snevindsouza/MAX10_Eval_Board_Design/bom/ALTERA_10M08_EVAL_20140911_REV_A_BOM_Altera.xls

MAX R 10 10M08 Eval Kit Board Revised: Thursday, September 11, 2014
150-0991402-A1 Revision: A
Item | Qty | Reference | VALUE | ASSY | DESCRIPTION | MFG | MFG P/N
1 | 1 | C1 | 4.7uF |  | CAP CER 4.7UF 6.3V 10% X5R 0603 | Taiyo Yuden | JMK107BJ475KA-T
2 | 28 | C2,C4,C5,C6,C7,C8,C9,C10,C13,C14,C15,C16,C17,C27,C29,C31,C33,C35,C36,C38,C40,C42,C46,C47,C48,C49,C51,C52 | 0.1uF |  | CAP CER 0.1UF 16V 10% X7R 0402 | Taiyo Yuden | EMK105B7104KV-F
3 | 1 | C3 | 47uF/16V |  | CAP ALUM 47UF 16V 20% SMD | Panasonic | EEE-1CA470WR
4 | 14 | C11,C12,C18,C28,C30,C32,C34,C37,C39,C41,C43,C44,C45,C61 | 1uF |  | CAP CER 1UF 6.3V 10% X5R 0402 | Taiyo Yuden | JMK105BJ105KV-F
5 | 16 | C19,C20,C21,C22,C23,C24,C25,C26,C53,C54,C55,C56,C57,C58,C59,C60 | 1nF |  | CAP CER 1000PF 50V 10% X7R 0402 | Yageo | CC0402KRX7R9BB102
6 | 1 | C50 | 10uF |  | CAP CER 10UF 10V 20% X5R 0603 | Taiyo Yuden | LMK107BJ106MALTD
7 | 5 | D1,D2,D3,D4,D5 | Red |  | LED SUPER RED CLEAR 0603 SMD | LITE-On INC | LTST-C190KRKT
8 | 1 | D6 | Green |  | LED SUPER GREEN CLEAR 0603 SMD | LITE-On INC | LTST-C190KGKT
9 | 2 | JU1,JU2 | 63429-202LF |  | CONN SHUNT SINGLE .100 GOLD | FCI | 63429-202LF
10 | 1 | J1 | SKT_MINIUSB_B_RA |  | CONN MINI USB RCPT RA TYPE B SMD | Multisource | 5075BMR-05-SM-CR
11 | 3 | J2,J4,J5 | PPTC081LFBN-RC |  | CONN HEADER FEMALE 8POS .1" TIN | Sullins Connector Solutions | PPTC081LFBN-RC
12 | 1 | J3 | PPTC081LFBN-RC |  | CONN HEADER FEMALE 8POS .1" TIN | Sullins Connector Solutions | PPTC081LFBN-RC
13 | 2 | J6,J7 | HEADER 3 |  | CONN HEADER VERT SGL 3POS GOLD | 3M | 961103-6404-AR
14 | 2 | J8,J9 | Header2x20 | DNI | CONN HEADER FMAL 40PS.1" DL GOLD | Sullins Connector Solutions | PPPC202LFBN-RC
15 | 1 | J10 | 70246-1004 |  | 2.54MM CGRID HDR 10CKT GOLD | Molex Inc | 702461004
16 | 1 | J11 | 87227-3 | DNI | CONN HEADER VERT .100 6POS 15AU | TE Connectivity | 87227-3
17 | 2 | L1,L2 | 600ohm 500mA |  | Ferrite Bead 600ohm@100MHz 500mA 0603 | Murata | BLM18AG601SN1D
18 | 1 | L3 | Ferrite Bead |  | FERRITE CHIP BEAD 47 OHM 0402 | TDK Corporation | MMZ1005F470C
19 | 2 | R1,R4 | 0.1 |  | RES 0.1 OHM 1/2W 1% 0805 WIDE | Rohm Semiconductor | LTR10EVHFLR100
20 | 18 | R2,R15,R51,R52,R53,R57,R58,R59,R60,R61,R62,R64,R65,R66,R67,R68,R69,R72 | 1K |  | RES 1.0K OHM 1/16W 5% 0402 SMD | Yageo | RC0402JR-071KL
21 | 1 | R3 | 100 | DNI | RES 100 OHM 1/8W 1% 0805 SMD | Yageo | RC0805FR-07100RL
22 | 13 | R6,R25,R26,R27,R38,R40,R47,R63,R70,R73,R75,R76,R77 | 0 |  | RES 0.0 OHM 1/16W JUMP 0402 SMD | Yageo | RC0402JR-070RL
23 | 15 | R7,R8,R9,R10,R17,R18,R19,R20,R78,R79,R80,R81,R82,R83,R85 | 316 |  | RES 316 OHM 1/10W 1% 0402 SMD | Panasonic Electronic Components | ERJ-2RKF3160X
24 | 1 | R16 | 10K | DNI | TRIMMER 10K OHM 0.1W SMD | Murata | PVZ3A103C01R00
25 | 19 | R29,R30,R31,R32,R33,R34,R35,R36,R37,R39,R41,R42,R43,R44,R45,R46,R48,R49,R50 | 100 | DNI | RES 100 OHM 1/10W 1% 0603 SMD | Yageo | RC0603FR-07100RL
26 | 3 | R54,R55,R56 | 10K |  | RES 10K OHM 1/16W 5% 0402 SMD | Yageo | RC0402JR-0710KL
27 | 1 | R74 | 0 | DNI | RES 0.0 OHM 1/16W JUMP 0402 SMD | Yageo | RC0402JR-070RL
28 | 1 | R84 | 316 | DNI | RES 316 OHM 1/10W 1% 0402 SMD | Panasonic Electronic Components | ERJ-2RKF3160X
29 | 8 | R86,R87,R88,R89,R90,R91,R92,R93 | 100 |  | RES 100 OHM 1/16W 1% 0402 SMD | Yageo | RC0402FR-07100RL
30 | 1 | R94 | 10K | DNI | TRIMMER 10K OHM 0.5W PC PIN | Bourns | 3362P-1-103TLF
31 | 2 | SW1,SW2 | PTS645SM43SMTR92 LFS |  | SWITCH TACTILE SPST-NO 0.05A 12V | C&K Components | PTS645SM43SMTR92 LFS
32 | 1 | SW3 | 219-6LPST |  | SWITCH TAPE SEAL 6 POS SMD 50V | CTS Electrocomponents | 219-6LPST
33 | 9 | TP1,TP2,TP3,TP4,TP5,TP6,TP7,TP8,TP9 | TP_S_40_63 | DNI | Square test point, 40mil inner diameter, 63mil outer diameter
34 | 1 | U1 | EP5388QI |  | DC/DC CONVERTER 0.6-5V 4W | Altera | EP5388QI
35 | 1 | U2 | MAX 10M08 |  | MAX 10 FPGA 10M08S | Altera | 10M08SAE144C7G
36 | 2 | U3,U4 | LM2902DR2 |  | IC OPAMP GP 1MHZ 14SOIC | ON Semiconductor | LM2902DR2
37 | 1 | U5 | MCP1525 |  | IC VREF SERIES 2.5V SOT23-3 | Microchip Technology | MCP1525T-I/TT
38 | 1 | X1 | CB3LV-3C-50M0000 |  | OSC 50MHz 3.3V 50ppm | CTS | CB3LV-3C-50M0000
