snevindsouza/MAX10_Eval_Board_Design/Resources/0805C/0805YC103J4T2A.step

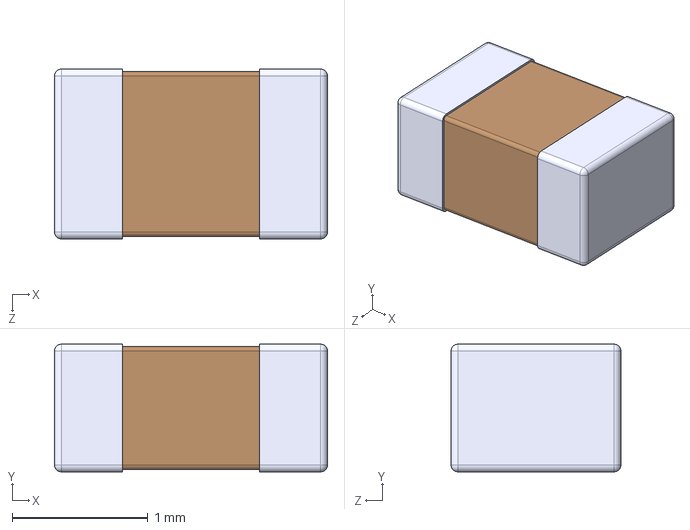
[picture p1: CAD file, 2024-08-09]
Resources/0805C/0805YC103J4T2A.step
2.01 x 0.94 x 1.25 mm
