snevindsouza/MAX10_Eval_Board_Design/Resources/0805R/RC0805FR-07330RL.step

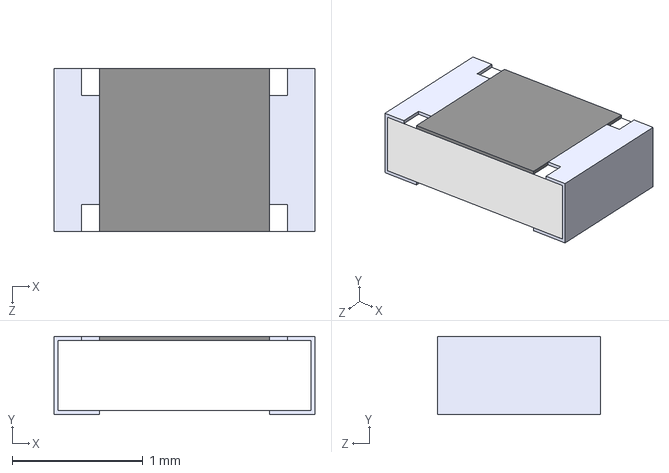
[picture p2: CAD file, 2024-08-09]
Resources/0805R/RC0805FR-07330RL.step
2.00 x 0.6 x 1.25 mm
