snevindsouza/MAX10_Eval_Board_Design/Resources/LM2902DR2/LM2902DR.step

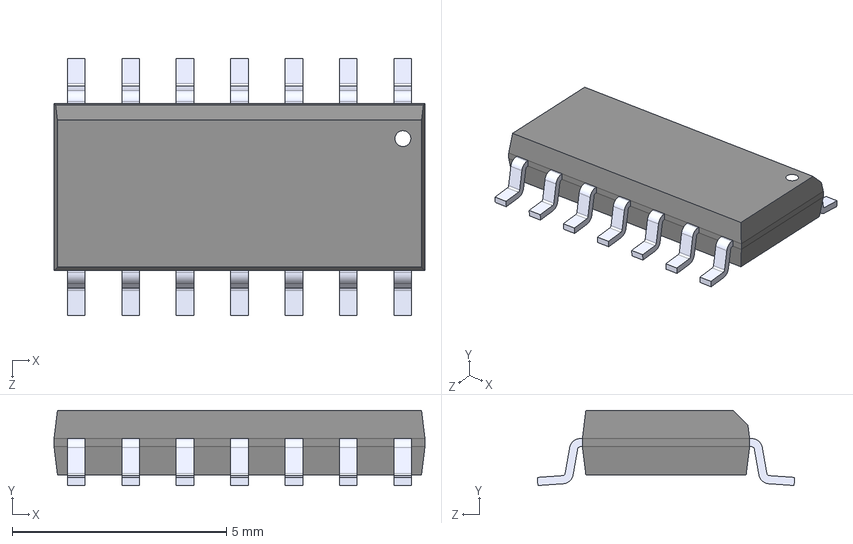
[picture p3: CAD file, 2024-08-09]
Resources/LM2902DR2/LM2902DR.step
8.65 x 1.75 x 6.00 mm
