snevindsouza/MAX10_Eval_Board_Design/Resources/oscillator/CB3LV-3C-30M0000.step

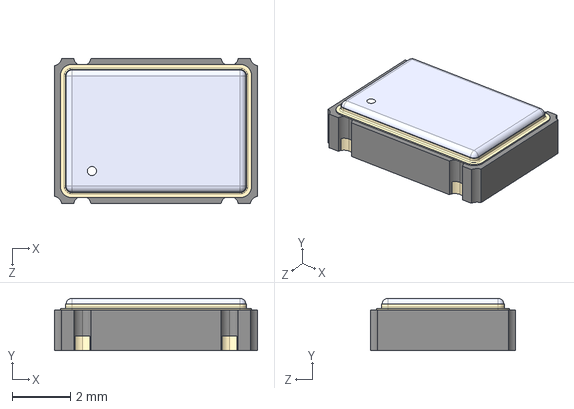
[picture p4: CAD file, 2024-08-09]
Resources/oscillator/CB3LV-3C-30M0000.step
7.00 x 1.80 x 5.00 mm
