snevindsouza/MAX10_Eval_Board_Design/LAYOUT.pdf

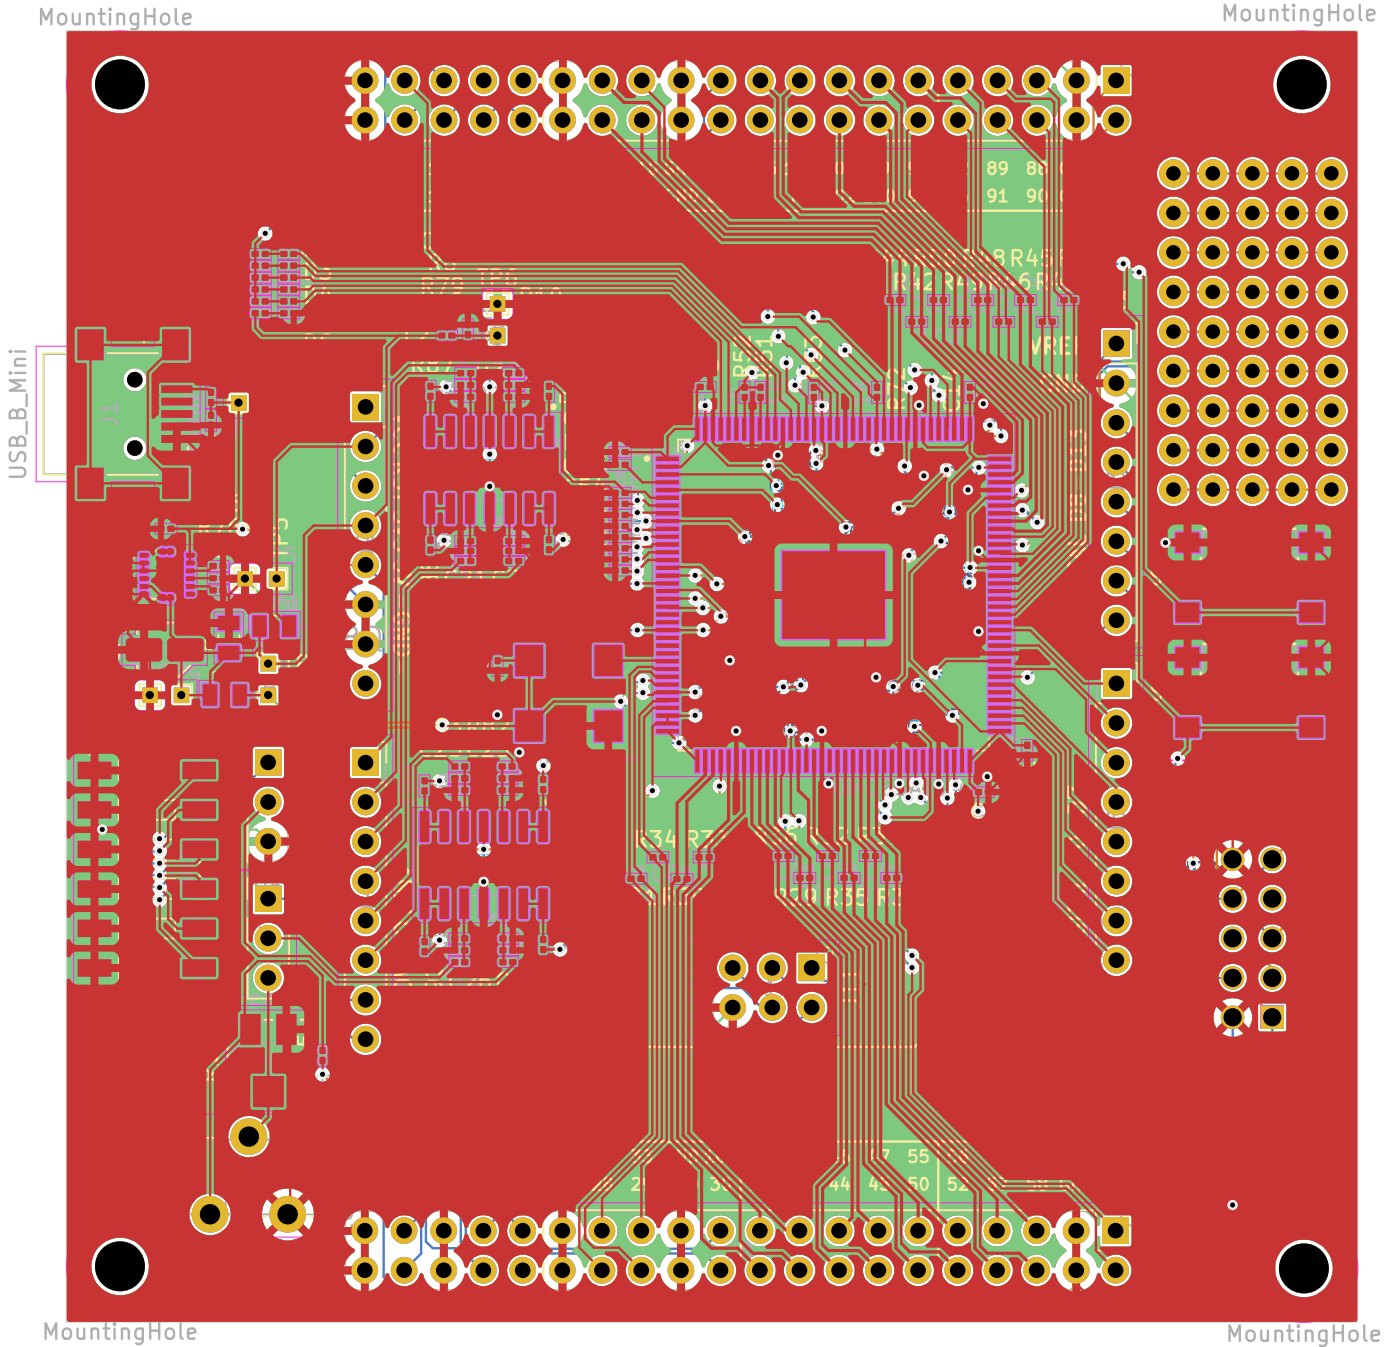
[picture p12: page 1]
