snevindsouza/MAX10_Eval_Board_Design/MAX10eval.kicad_pcb

## KiCad design MAX10eval.kicad_pcb (2024-08-09)

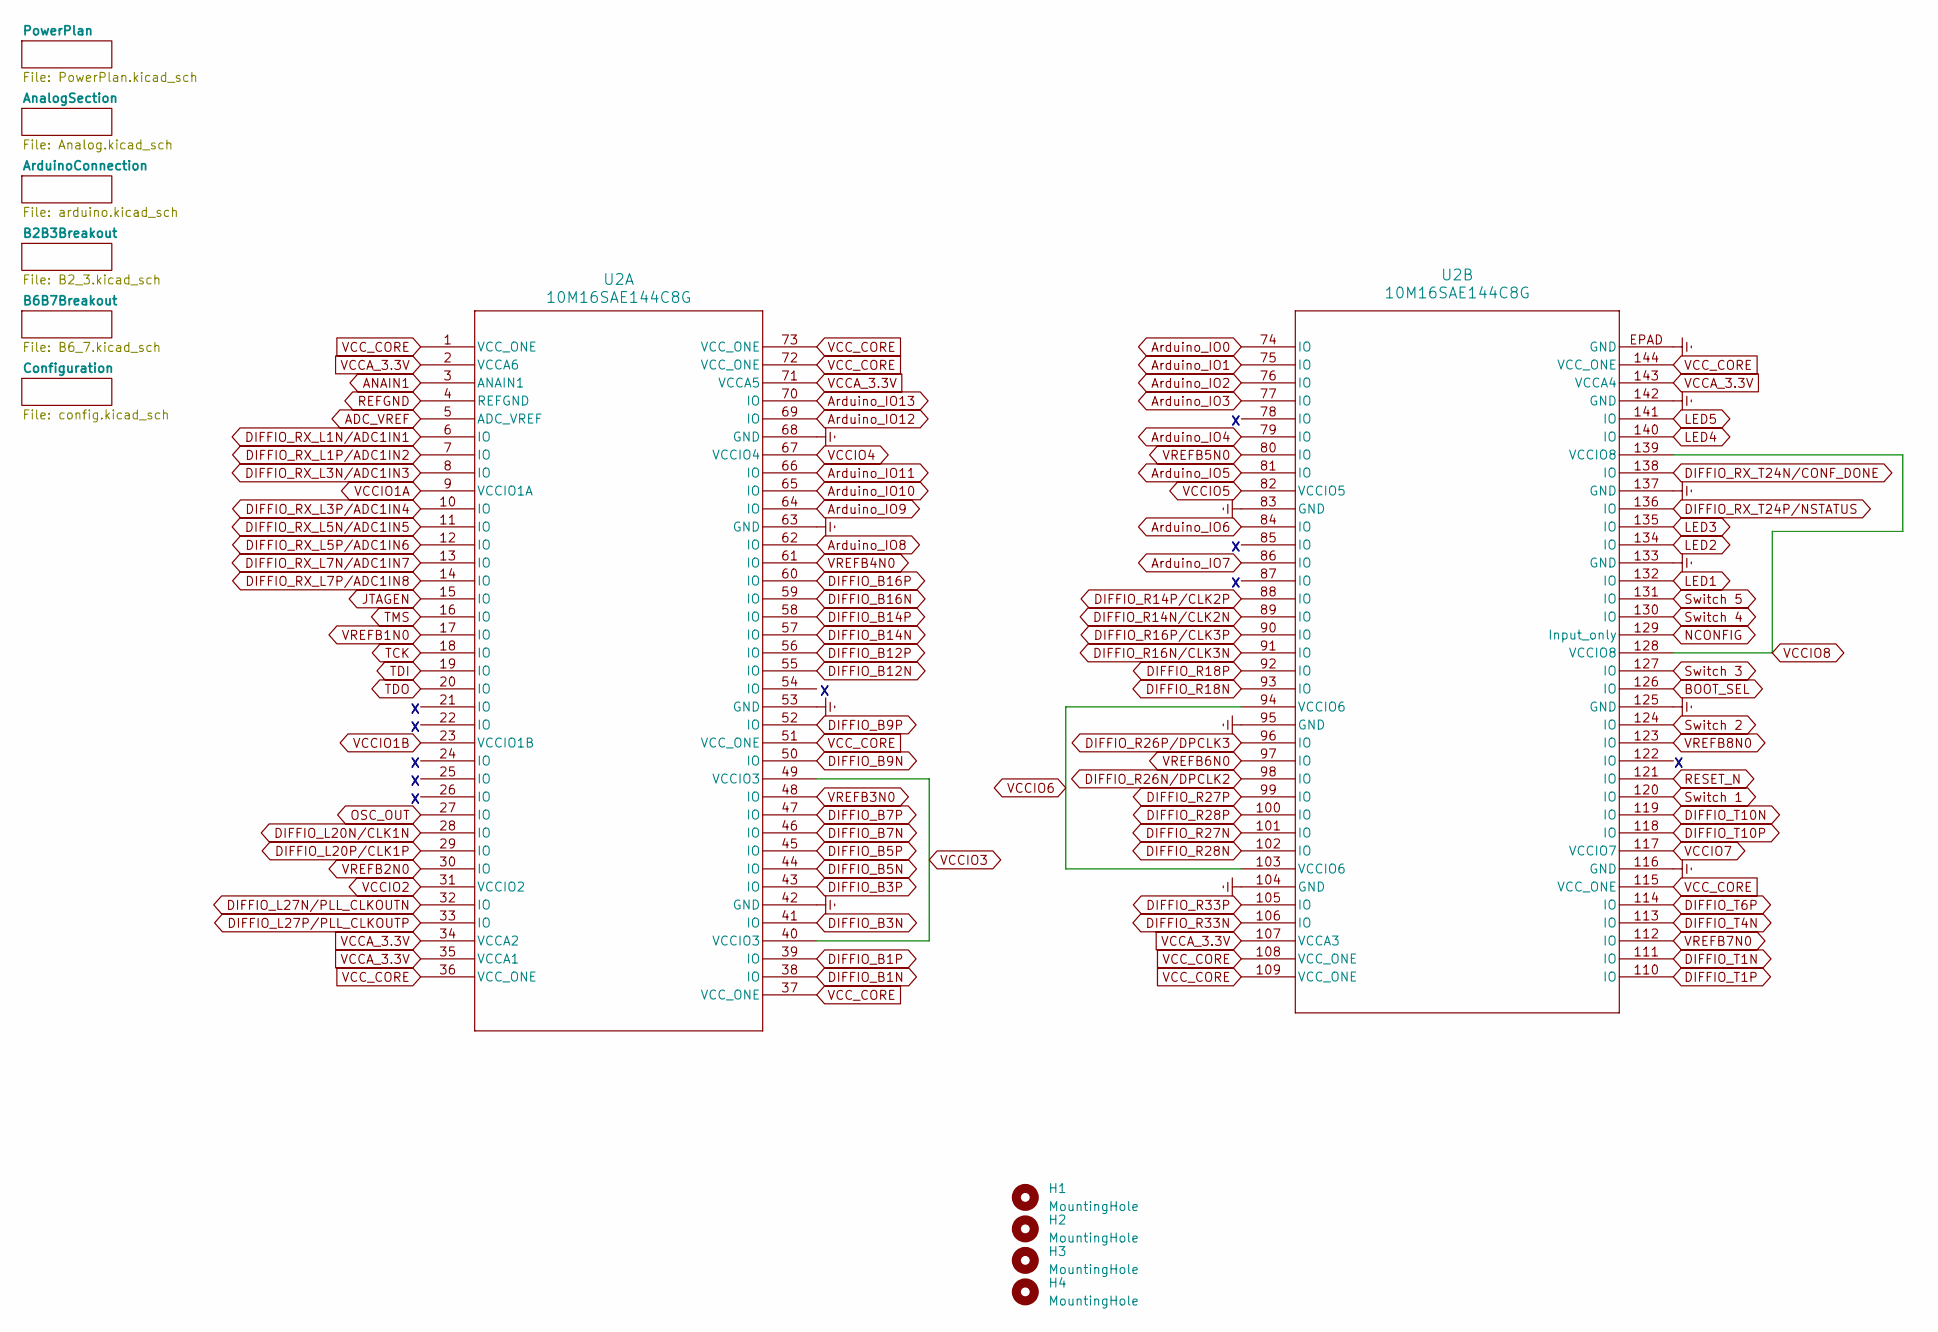
[picture p13: schematic MAX10eval.kicad_sch, MAX10-FPGA-EVAL-BOARD]

Parts:
H1, H2, H3, H4: MountingHole; MountingHole_3.2mm_M3
U2: 10M16SAE144C8G; 10M16SAE114C8G

Connections:
ADC_VREF: U2.5 (ADC_VREF); also elsewhere on the board
ANAIN1: U2.3 (ANAIN1); also elsewhere on the board
Arduino_IO0: U2.74 (IO); also elsewhere on the board
Arduino_IO1: U2.75 (IO); also elsewhere on the board
Arduino_IO2: U2.76 (IO); also elsewhere on the board
Arduino_IO3: U2.77 (IO); also elsewhere on the board
Arduino_IO4: U2.79 (IO); also elsewhere on the board
Arduino_IO5: U2.81 (IO); also elsewhere on the board
Arduino_IO6: U2.84 (IO); also elsewhere on the board
Arduino_IO7: U2.86 (IO); also elsewhere on the board
Arduino_IO8: U2.62 (IO); also elsewhere on the board
Arduino_IO9: U2.64 (IO); also elsewhere on the board
Arduino_IO10: U2.65 (IO); also elsewhere on the board
Arduino_IO11: U2.66 (IO); also elsewhere on the board
Arduino_IO12: U2.69 (IO); also elsewhere on the board
Arduino_IO13: U2.70 (IO); also elsewhere on the board
BOOT_SEL: U2.126 (IO); also elsewhere on the board
DIFFIO_B1N: U2.38 (IO); also elsewhere on the board
DIFFIO_B1P: U2.39 (IO); also elsewhere on the board
DIFFIO_B3N: U2.41 (IO); also elsewhere on the board
DIFFIO_B3P: U2.43 (IO); also elsewhere on the board
DIFFIO_B5N: U2.44 (IO); also elsewhere on the board
DIFFIO_B5P: U2.45 (IO); also elsewhere on the board
DIFFIO_B7N: U2.46 (IO); also elsewhere on the board
DIFFIO_B7P: U2.47 (IO); also elsewhere on the board
DIFFIO_B9N: U2.50 (IO); also elsewhere on the board
DIFFIO_B9P: U2.52 (IO); also elsewhere on the board
DIFFIO_B12N: U2.55 (IO); also elsewhere on the board
DIFFIO_B12P: U2.56 (IO); also elsewhere on the board
DIFFIO_B14N: U2.57 (IO); also elsewhere on the board
DIFFIO_B14P: U2.58 (IO); also elsewhere on the board
DIFFIO_B16N: U2.59 (IO); also elsewhere on the board
DIFFIO_B16P: U2.60 (IO); also elsewhere on the board
DIFFIO_L20N/CLK1N: U2.28 (IO); also elsewhere on the board
DIFFIO_L20P/CLK1P: U2.29 (IO); also elsewhere on the board
DIFFIO_L27N/PLL_CLKOUTN: U2.32 (IO); also elsewhere on the board
DIFFIO_L27P/PLL_CLKOUTP: U2.33 (IO); also elsewhere on the board
DIFFIO_R14N/CLK2N: U2.89 (IO); also elsewhere on the board
DIFFIO_R14P/CLK2P: U2.88 (IO); also elsewhere on the board
DIFFIO_R16N/CLK3N: U2.91 (IO); also elsewhere on the board
DIFFIO_R16P/CLK3P: U2.90 (IO); also elsewhere on the board
DIFFIO_R18N: U2.93 (IO); also elsewhere on the board
DIFFIO_R18P: U2.92 (IO); also elsewhere on the board
DIFFIO_R26N/DPCLK2: U2.98 (IO); also elsewhere on the board
DIFFIO_R26P/DPCLK3: U2.96 (IO); also elsewhere on the board
DIFFIO_R27N: U2.101 (IO); also elsewhere on the board
DIFFIO_R27P: U2.99 (IO); also elsewhere on the board
DIFFIO_R28N: U2.102 (IO); also elsewhere on the board
DIFFIO_R28P: U2.100 (IO); also elsewhere on the board
DIFFIO_R33N: U2.106 (IO); also elsewhere on the board
DIFFIO_R33P: U2.105 (IO); also elsewhere on the board
DIFFIO_RX_L1N/ADC1IN1: U2.6 (IO); also elsewhere on the board
DIFFIO_RX_L1P/ADC1IN2: U2.7 (IO); also elsewhere on the board
DIFFIO_RX_L3N/ADC1IN3: U2.8 (IO); also elsewhere on the board
DIFFIO_RX_L3P/ADC1IN4: U2.10 (IO); also elsewhere on the board
DIFFIO_RX_L5N/ADC1IN5: U2.11 (IO); also elsewhere on the board
DIFFIO_RX_L5P/ADC1IN6: U2.12 (IO); also elsewhere on the board
DIFFIO_RX_L7N/ADC1IN7: U2.13 (IO); also elsewhere on the board
DIFFIO_RX_L7P/ADC1IN8: U2.14 (IO); also elsewhere on the board
DIFFIO_RX_T24N/CONF_DONE: U2.138 (IO); also elsewhere on the board
DIFFIO_RX_T24P/NSTATUS: U2.136 (IO); also elsewhere on the board
DIFFIO_T1N: U2.111 (IO); also elsewhere on the board
DIFFIO_T1P: U2.110 (IO); also elsewhere on the board
DIFFIO_T4N: U2.113 (IO); also elsewhere on the board
DIFFIO_T6P: U2.114 (IO); also elsewhere on the board
DIFFIO_T10N: U2.119 (IO); also elsewhere on the board
DIFFIO_T10P: U2.118 (IO); also elsewhere on the board
Earth: U2.42 (GND), U2.53 (GND), U2.63 (GND), U2.68 (GND), U2.83 (GND), U2.95 (GND), U2.104 (GND), U2.116 (GND), U2.125 (GND), U2.133 (GND), U2.137 (GND), U2.142 (GND), U2.EPAD (GND); also elsewhere on the board
JTAGEN: U2.15 (IO); also elsewhere on the board
LED1: U2.132 (IO); also elsewhere on the board
LED2: U2.134 (IO); also elsewhere on the board
LED3: U2.135 (IO); also elsewhere on the board
LED4: U2.140 (IO); also elsewhere on the board
LED5: U2.141 (IO); also elsewhere on the board
NCONFIG: U2.129 (Input_only); also elsewhere on the board
OSC_OUT: U2.27 (IO); also elsewhere on the board
REFGND: U2.4 (REFGND); also elsewhere on the board
RESET_N: U2.121 (IO); also elsewhere on the board
Switch 1: U2.120 (IO); also elsewhere on the board
Switch 2: U2.124 (IO); also elsewhere on the board
Switch 3: U2.127 (IO); also elsewhere on the board
Switch 4: U2.130 (IO); also elsewhere on the board
Switch 5: U2.131 (IO); also elsewhere on the board
TCK: U2.18 (IO); also elsewhere on the board
TDI: U2.19 (IO); also elsewhere on the board
TDO: U2.20 (IO); also elsewhere on the board
TMS: U2.16 (IO); also elsewhere on the board
VCCA_3.3V: U2.2 (VCCA6), U2.34 (VCCA2), U2.35 (VCCA1), U2.71 (VCCA5), U2.107 (VCCA3), U2.143 (VCCA4); also elsewhere on the board
VCCIO1A: U2.9 (VCCIO1A); also elsewhere on the board
VCCIO1B: U2.23 (VCCIO1B); also elsewhere on the board
VCCIO2: U2.31 (VCCIO2); also elsewhere on the board
VCCIO3: U2.40 (VCCIO3), U2.49 (VCCIO3); also elsewhere on the board
VCCIO4: U2.67 (VCCIO4); also elsewhere on the board
VCCIO5: U2.82 (VCCIO5); also elsewhere on the board
VCCIO6: U2.94 (VCCIO6), U2.103 (VCCIO6); also elsewhere on the board
VCCIO7: U2.117 (VCCIO7); also elsewhere on the board
VCCIO8: U2.128 (VCCIO8), U2.139 (VCCIO8); also elsewhere on the board
VCC_CORE: U2.1 (VCC_ONE), U2.36 (VCC_ONE), U2.37 (VCC_ONE), U2.51 (VCC_ONE), U2.72 (VCC_ONE), U2.73 (VCC_ONE), U2.108 (VCC_ONE), U2.109 (VCC_ONE), U2.115 (VCC_ONE), U2.144 (VCC_ONE); also elsewhere on the board
VREFB1N0: U2.17 (IO); also elsewhere on the board
VREFB2N0: U2.30 (IO); also elsewhere on the board
VREFB3N0: U2.48 (IO); also elsewhere on the board
VREFB4N0: U2.61 (IO); also elsewhere on the board
VREFB5N0: U2.80 (IO); also elsewhere on the board
VREFB6N0: U2.97 (IO); also elsewhere on the board
VREFB7N0: U2.112 (IO); also elsewhere on the board
VREFB8N0: U2.123 (IO); also elsewhere on the board

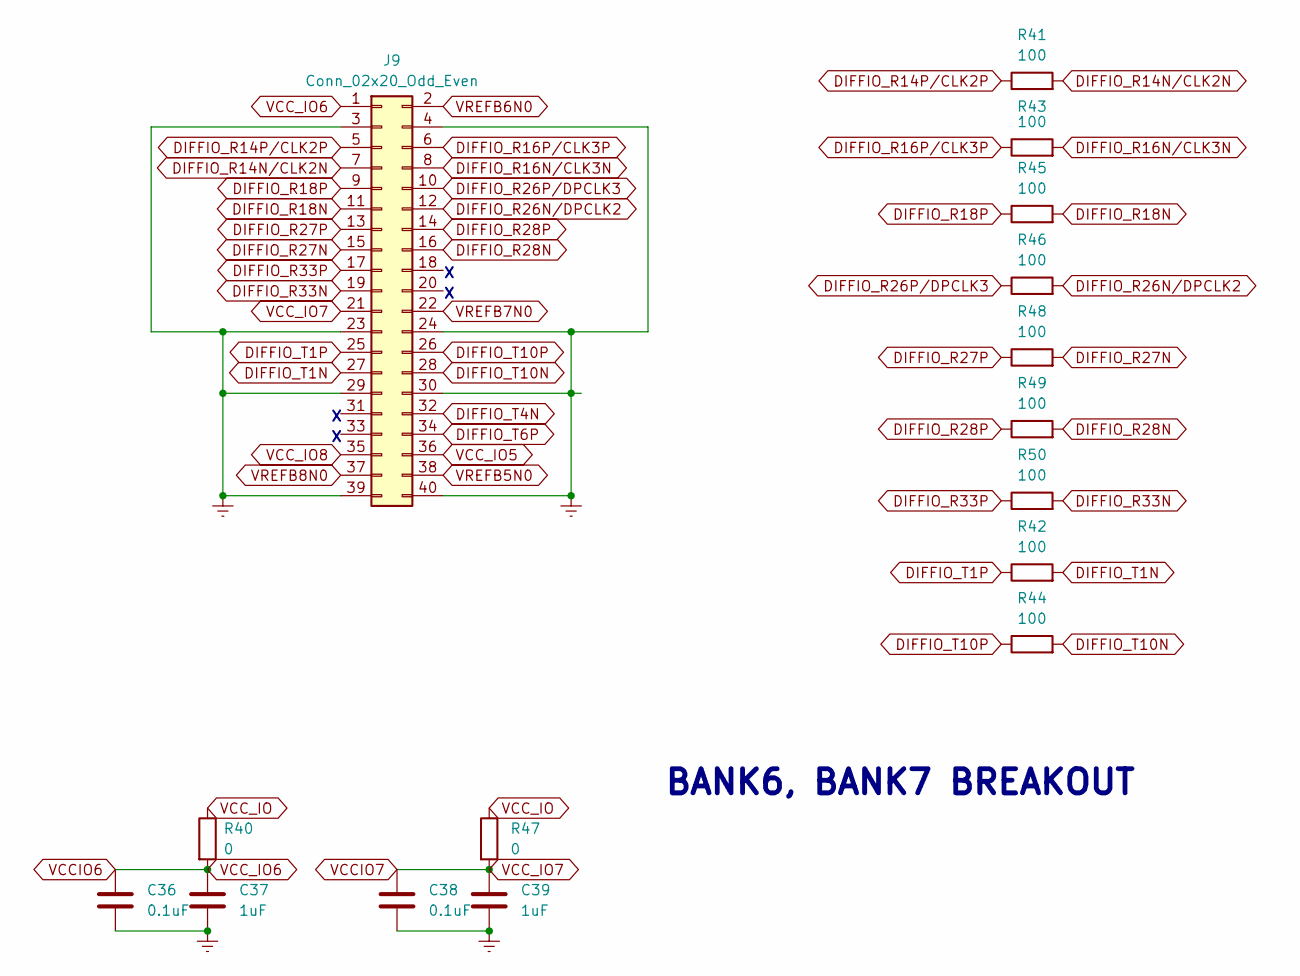
[picture p14: schematic B6_7.kicad_sch]

Parts:
C36, C38: 0.1uF; C_0201_0603Metric
C37, C39: 1uF; C_0201_0603Metric
J9: Conn_02x20_Odd_Even; PinHeader_2x20_P2.54mm_Vertical
R40, R47: 0; R_0201_0603Metric
R41, R42, R43, R44, R45, R46, R48, R49, R50: 100; R_0201_0603Metric

Connections:
DIFFIO_R14N/CLK2N: J9.7, R41.2; also elsewhere on the board
DIFFIO_R14P/CLK2P: J9.5, R41.1; also elsewhere on the board
DIFFIO_R16N/CLK3N: J9.8, R43.2; also elsewhere on the board
DIFFIO_R16P/CLK3P: J9.6, R43.1; also elsewhere on the board
DIFFIO_R18N: J9.11, R45.2; also elsewhere on the board
DIFFIO_R18P: J9.9, R45.1; also elsewhere on the board
DIFFIO_R26N/DPCLK2: J9.12, R46.2; also elsewhere on the board
DIFFIO_R26P/DPCLK3: J9.10, R46.1; also elsewhere on the board
DIFFIO_R27N: J9.15, R48.2; also elsewhere on the board
DIFFIO_R27P: J9.13, R48.1; also elsewhere on the board
DIFFIO_R28N: J9.16, R49.2; also elsewhere on the board
DIFFIO_R28P: J9.14, R49.1; also elsewhere on the board
DIFFIO_R33N: J9.19, R50.2; also elsewhere on the board
DIFFIO_R33P: J9.17, R50.1; also elsewhere on the board
DIFFIO_T1N: J9.27, R42.2; also elsewhere on the board
DIFFIO_T1P: J9.25, R42.1; also elsewhere on the board
DIFFIO_T4N: J9.32; also elsewhere on the board
DIFFIO_T6P: J9.34; also elsewhere on the board
DIFFIO_T10N: J9.28, R44.2; also elsewhere on the board
DIFFIO_T10P: J9.26, R44.1; also elsewhere on the board
Earth: C36.2, C37.2, C38.2, C39.2, J9.3, J9.4, J9.23, J9.24, J9.29, J9.30, J9.39, J9.40; also elsewhere on the board
VCCIO5: J9.36; also elsewhere on the board
VCCIO6: C36.1, C37.1, J9.1, R40.2; also elsewhere on the board
VCCIO7: C38.1, C39.1, J9.21, R47.2; also elsewhere on the board
VCCIO8: J9.35; also elsewhere on the board
VCC_IO: R40.1, R47.1; also elsewhere on the board
VREFB5N0: J9.38; also elsewhere on the board
VREFB6N0: J9.2; also elsewhere on the board
VREFB7N0: J9.22; also elsewhere on the board
VREFB8N0: J9.37; also elsewhere on the board

Notes on the sheet:
BANK6, BANK7 BREAKOUT

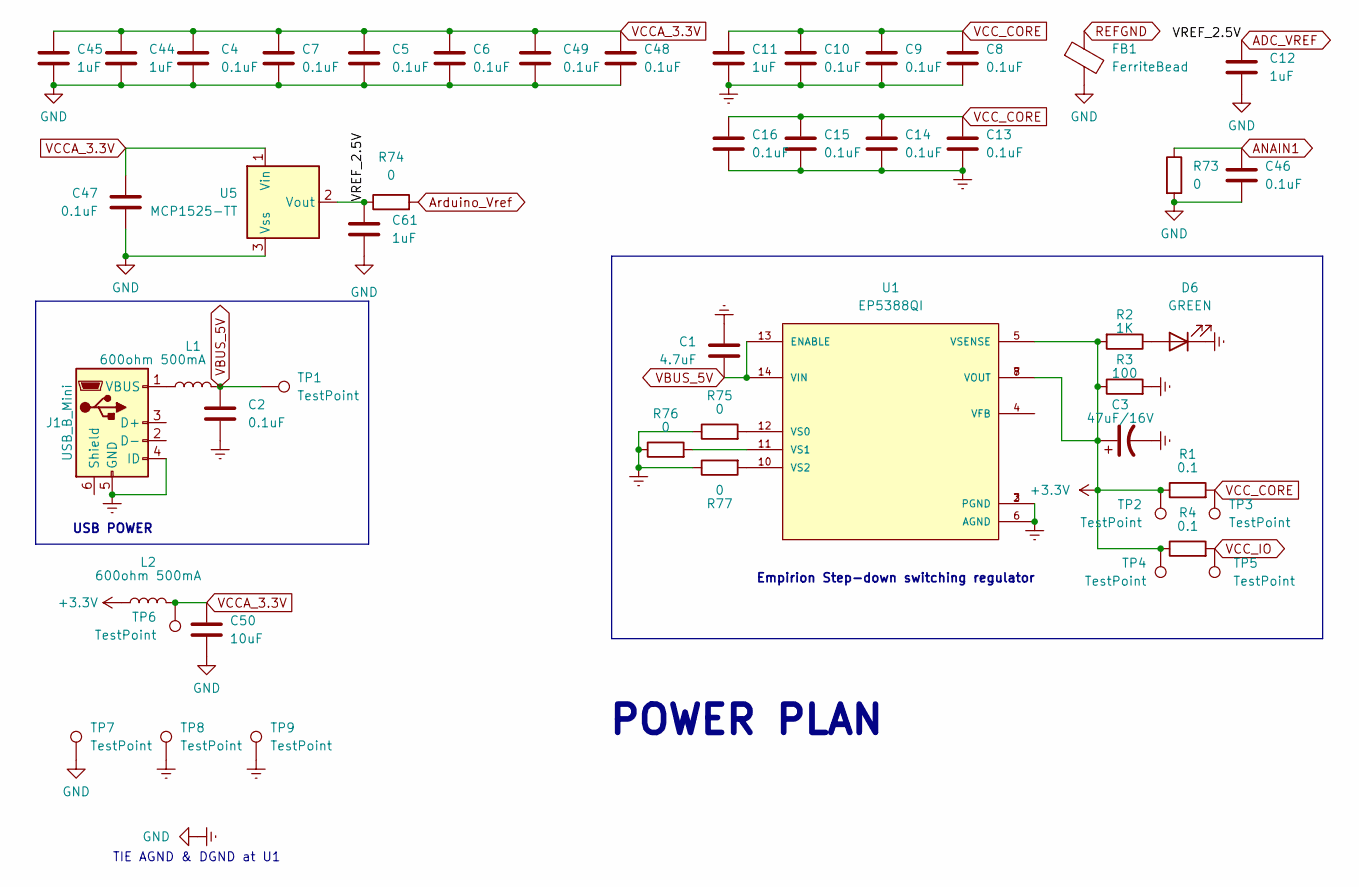
[picture p15: schematic PowerPlan.kicad_sch]

Parts:
C1: 4.7uF; C_0201_0603Metric
C2, C4, C5, C6, C7, C8, C9, C10, C13, C14, C15, C16, C46, C47, C48, C49: 0.1uF; C_0201_0603Metric
C3: 47uF/16V; C_Elec_3x5.4
C11, C12, C44, C45, C61: 1uF; C_0201_0603Metric
C50: 10uF; C_0201_0603Metric
D6: GREEN; LED_0201_0603Metric
FB1: FerriteBead; L_0201_0603Metric
J1: USB_B_Mini; USB_Mini-B_Lumberg_2486_01_Horizontal
L1, L2: 600ohm 500mA; L_0201_0603Metric
R1, R4: 0.1; RESC2012X60N
R2: 1K; R_0201_0603Metric
R3: 100; RESC2012X60N
R73, R74, R75, R76, R77: 0; R_0201_0603Metric
TP1, TP2, TP3, TP4, TP5, TP6, TP7, TP8, TP9: TestPoint; TestPoint_THTPad_1.0x1.0mm_Drill0.5mm
U1: EP5388QI; CONV_EP5388QI; PARTREV H
U5: MCP1525-TT; SOT-23

Connections:
+3.3V: C3.1, L2.1, R1.1, R2.2, R3.1, R4.1, TP2.1, TP4.1, U1.5 (VSENSE), U1.7 (VOUT), U1.8 (VOUT); also elsewhere on the board
ADC_VREF: C12.1, C61.1, R74.1, U5.2 (Vout); also elsewhere on the board
ANAIN1: C46.1, R73.1; also elsewhere on the board
Arduino_Vref: R74.2; also elsewhere on the board
Earth: C1.2, C2.2, C3.2, C4.2, C5.2, C6.2, C7.2, C8.2, C9.2, C10.2, C11.2, C12.2, C13.2, C14.2, C15.2, C16.2, C44.2, C45.2, C46.2, C47.2, C48.2, C49.2, C50.2, C61.2, D6.1 (K), FB1.2, J1.4 (ID), J1.5 (GND), R3.2, R73.2, R75.1, R76.1, R77.1, TP7.1, TP8.1, TP9.1, U1.2 (PGND), U1.3 (PGND), U1.6 (AGND), U5.3 (Vss); also elsewhere on the board
unnamed: D6.2 (A), R2.1
unnamed: J1.1 (VBUS), L1.1
unnamed: R75.2, U1.12 (VS0)
unnamed: R76.2, U1.11 (VS1)
unnamed: R77.2, U1.10 (VS2)
REFGND: FB1.1; also elsewhere on the board
VBUS_5V: C1.1, C2.1, L1.2, TP1.1, U1.13 (ENABLE), U1.14 (VIN); also elsewhere on the board
VCCA_3.3V: C4.1, C5.1, C6.1, C7.1, C44.1, C45.1, C47.1, C48.1, C49.1, C50.1, L2.2, TP6.1, U5.1 (Vin); also elsewhere on the board
VCC_CORE: C8.1, C9.1, C10.1, C11.1, C13.1, C14.1, C15.1, C16.1, R1.2, TP3.1; also elsewhere on the board
VCC_IO: R4.2, TP5.1; also elsewhere on the board

Notes on the sheet:
TIE AGND & DGND at U1
Empirion Step-down switching regulator
POWER PLAN
USB POWER

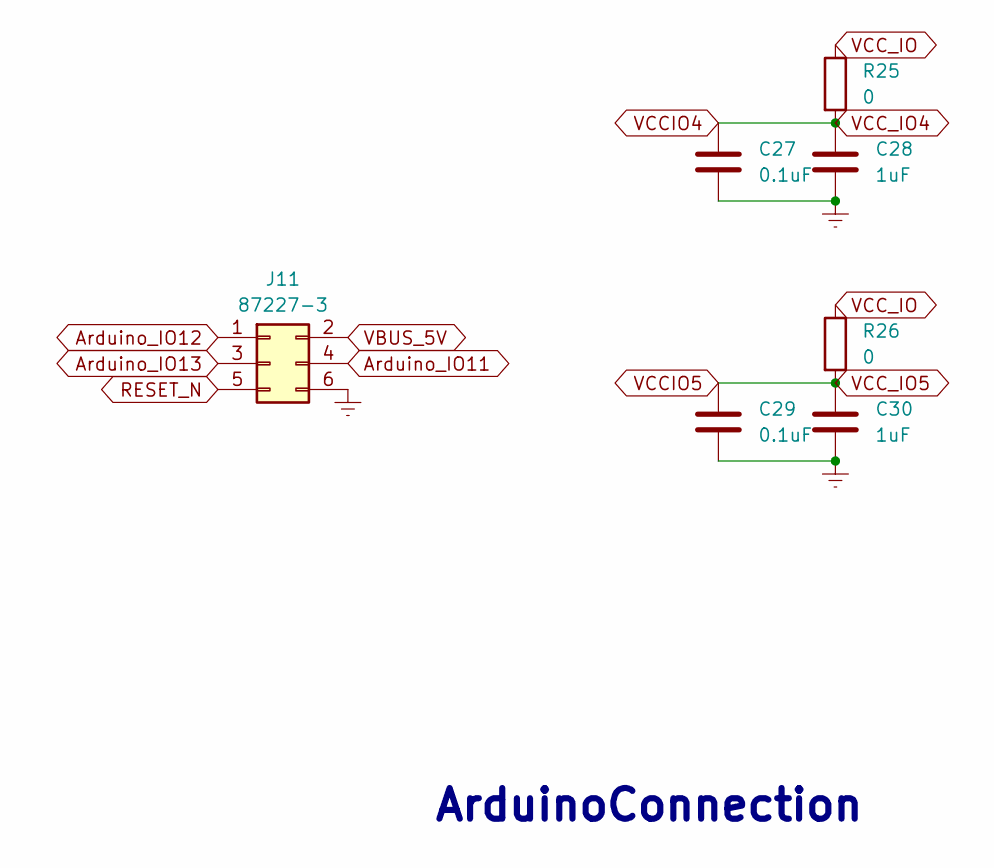
[picture p16: schematic arduino.kicad_sch]

Parts:
C27, C29: 0.1uF; C_0201_0603Metric
C28, C30: 1uF; C_0201_0603Metric
J11: 87227-3; PinHeader_2x03_P2.54mm_Vertical
R25, R26: 0; R_0201_0603Metric

Connections:
Arduino_IO11: J11.4; also elsewhere on the board
Arduino_IO12: J11.1; also elsewhere on the board
Arduino_IO13: J11.3; also elsewhere on the board
Earth: C27.2, C28.2, C29.2, C30.2, J11.6; also elsewhere on the board
RESET_N: J11.5; also elsewhere on the board
VBUS_5V: J11.2; also elsewhere on the board
VCCIO4: C27.1, C28.1, R25.2; also elsewhere on the board
VCCIO5: C29.1, C30.1, R26.2; also elsewhere on the board
VCC_IO: R25.1, R26.1; also elsewhere on the board

Notes on the sheet:
ArduinoConnection

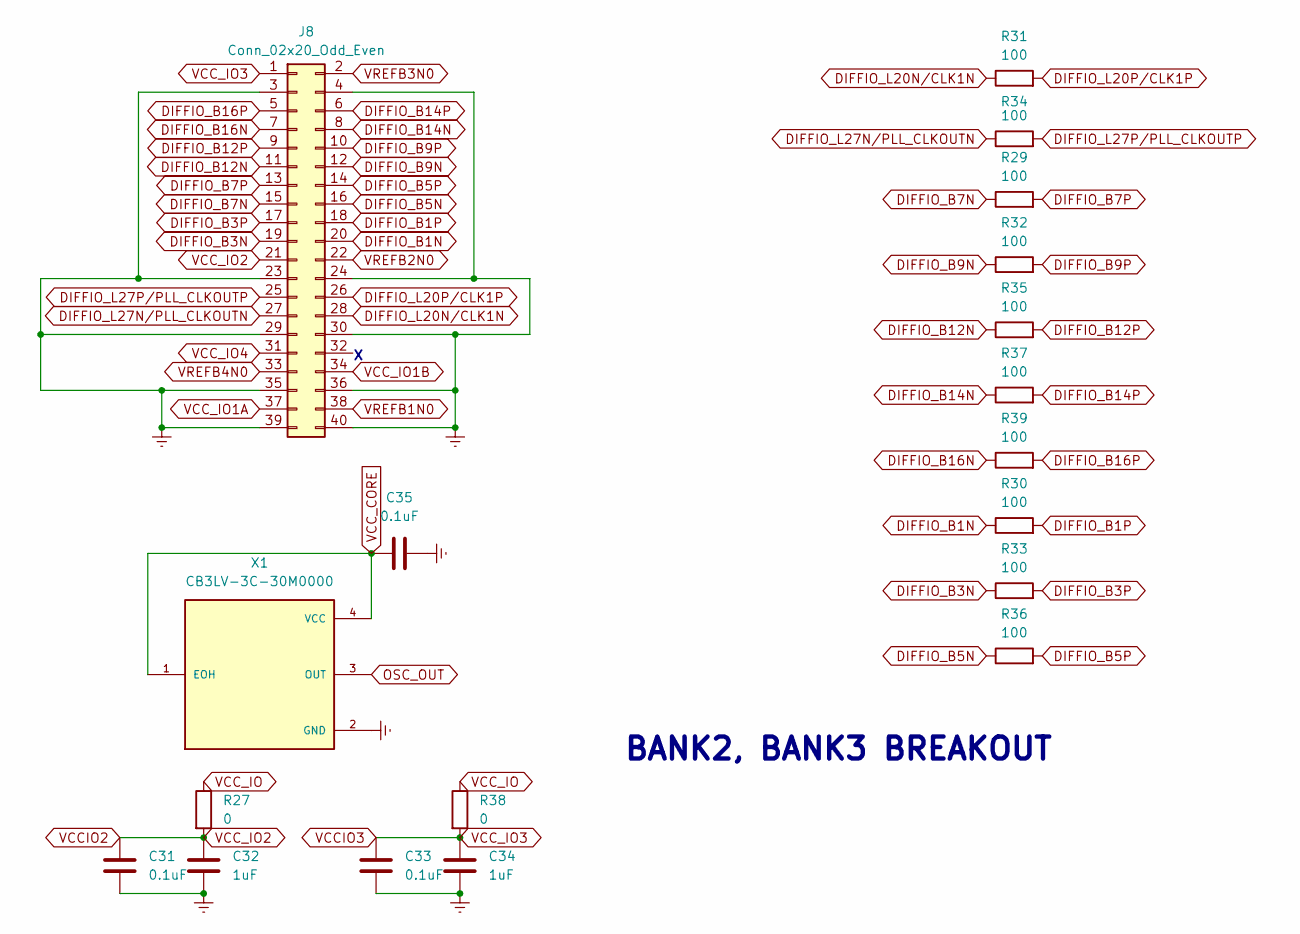
[picture p17: schematic B2_3.kicad_sch]

Parts:
C31, C33, C35: 0.1uF; C_0201_0603Metric
C32, C34: 1uF; C_0201_0603Metric
J8: Conn_02x20_Odd_Even; PinHeader_2x20_P2.54mm_Vertical
R27, R38: 0; R_0201_0603Metric
R29, R30, R31, R32, R33, R34, R35, R36, R37, R39: 100; R_0201_0603Metric
X1: CB3LV-3C-30M0000; OSCCC700X500X180-4N

Connections:
DIFFIO_B1N: J8.20, R30.1; also elsewhere on the board
DIFFIO_B1P: J8.18, R30.2; also elsewhere on the board
DIFFIO_B3N: J8.19, R33.1; also elsewhere on the board
DIFFIO_B3P: J8.17, R33.2; also elsewhere on the board
DIFFIO_B5N: J8.16, R36.1; also elsewhere on the board
DIFFIO_B5P: J8.14, R36.2; also elsewhere on the board
DIFFIO_B7N: J8.15, R29.1; also elsewhere on the board
DIFFIO_B7P: J8.13, R29.2; also elsewhere on the board
DIFFIO_B9N: J8.12, R32.1; also elsewhere on the board
DIFFIO_B9P: J8.10, R32.2; also elsewhere on the board
DIFFIO_B12N: J8.11, R35.1; also elsewhere on the board
DIFFIO_B12P: J8.9, R35.2; also elsewhere on the board
DIFFIO_B14N: J8.8, R37.1; also elsewhere on the board
DIFFIO_B14P: J8.6, R37.2; also elsewhere on the board
DIFFIO_B16N: J8.7, R39.1; also elsewhere on the board
DIFFIO_B16P: J8.5, R39.2; also elsewhere on the board
DIFFIO_L20N/CLK1N: J8.28, R31.1; also elsewhere on the board
DIFFIO_L20P/CLK1P: J8.26, R31.2; also elsewhere on the board
DIFFIO_L27N/PLL_CLKOUTN: J8.27, R34.1; also elsewhere on the board
DIFFIO_L27P/PLL_CLKOUTP: J8.25, R34.2; also elsewhere on the board
Earth: C31.2, C32.2, C33.2, C34.2, C35.2, J8.3, J8.4, J8.23, J8.24, J8.29, J8.30, J8.35, J8.36, J8.39, J8.40, X1.2 (GND); also elsewhere on the board
OSC_OUT: X1.3 (OUT); also elsewhere on the board
VCCIO1A: J8.37; also elsewhere on the board
VCCIO1B: J8.34; also elsewhere on the board
VCCIO2: C31.1, C32.1, J8.21, R27.2; also elsewhere on the board
VCCIO3: C33.1, C34.1, J8.1, R38.2; also elsewhere on the board
VCCIO4: J8.31; also elsewhere on the board
VCC_CORE: C35.1, X1.1 (EOH), X1.4 (VCC); also elsewhere on the board
VCC_IO: R27.1, R38.1; also elsewhere on the board
VREFB1N0: J8.38; also elsewhere on the board
VREFB2N0: J8.22; also elsewhere on the board
VREFB3N0: J8.2; also elsewhere on the board
VREFB4N0: J8.33; also elsewhere on the board

Notes on the sheet:
BANK2, BANK3 BREAKOUT

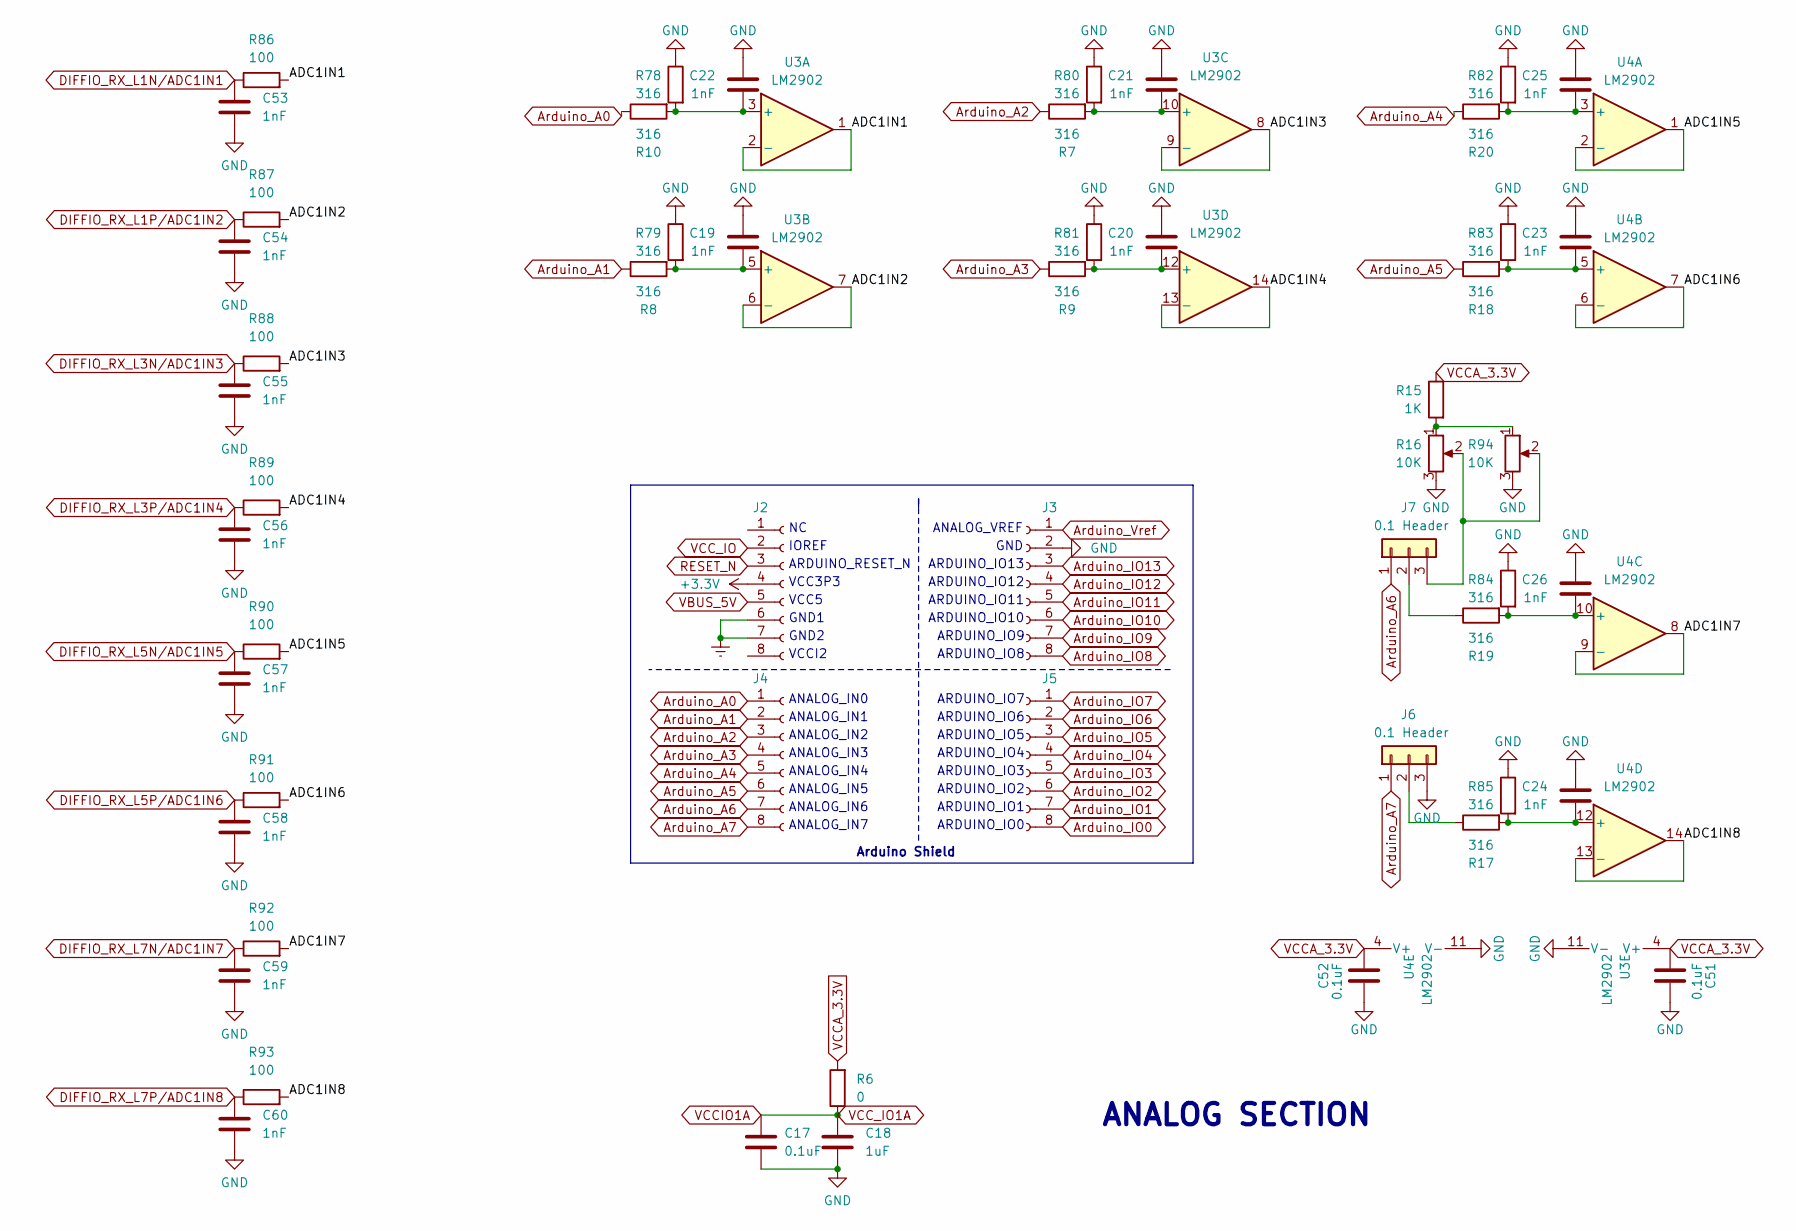
[picture p18: schematic Analog.kicad_sch]

Parts:
C17, C51, C52: 0.1uF; C_0201_0603Metric
C18: 1uF; C_0201_0603Metric
C19, C20, C21, C22, C23, C24, C25, C26, C53, C54, C55, C56, C57, C58, C59, C60: 1nF; C_0201_0603Metric
J2, J3, J4, J5: Conn_01x08_Socket; PinSocket_1x08_P2.54mm_Vertical
J6, J7: 0.1 Header; PinHeader_1x03_P2.54mm_Vertical
R6: 0; R_0201_0603Metric
R7, R8, R9, R10, R17, R18, R19, R20, R78, R79, R80, R81, R82, R83, R84, R85: 316; R_0201_0603Metric
R15: 1K; R_0201_0603Metric
R16: 10K; Potentiometer_Vishay_TS53YJ_Vertical
R86, R87, R88, R89, R90, R91, R92, R93: 100; R_0201_0603Metric
R94: 10K; Potentiometer_ACP_CA9-H5_Horizontal
U3, U4: LM2902; SOIC127P600X175-14N

Connections:
+3.3V: J2.4; also elsewhere on the board
/AnalogSection/ADC1IN1: R86.2, U3.1, U3.2 (-)
/AnalogSection/ADC1IN2: R87.2, U3.6 (-), U3.7
/AnalogSection/ADC1IN3: R88.2, U3.8, U3.9 (-)
/AnalogSection/ADC1IN4: R89.2, U3.13 (-), U3.14
/AnalogSection/ADC1IN5: R90.2, U4.1, U4.2 (-)
/AnalogSection/ADC1IN6: R91.2, U4.6 (-), U4.7
/AnalogSection/ADC1IN7: R92.2, U4.8, U4.9 (-)
/AnalogSection/ADC1IN8: R93.2, U4.13 (-), U4.14
Arduino_A0: J4.1, R10.1
Arduino_A1: J4.2, R8.1
Arduino_A2: J4.3, R7.1
Arduino_A3: J4.4, R9.1
Arduino_A4: J4.5, R20.1
Arduino_A5: J4.6, R18.1
Arduino_A6: J4.7, J7.1
Arduino_A7: J4.8, J6.1
Arduino_IO0: J5.8; also elsewhere on the board
Arduino_IO1: J5.7; also elsewhere on the board
Arduino_IO2: J5.6; also elsewhere on the board
Arduino_IO3: J5.5; also elsewhere on the board
Arduino_IO4: J5.4; also elsewhere on the board
Arduino_IO5: J5.3; also elsewhere on the board
Arduino_IO6: J5.2; also elsewhere on the board
Arduino_IO7: J5.1; also elsewhere on the board
Arduino_IO8: J3.8; also elsewhere on the board
Arduino_IO9: J3.7; also elsewhere on the board
Arduino_IO10: J3.6; also elsewhere on the board
Arduino_IO11: J3.5; also elsewhere on the board
Arduino_IO12: J3.4; also elsewhere on the board
Arduino_IO13: J3.3; also elsewhere on the board
Arduino_Vref: J3.1; also elsewhere on the board
DIFFIO_RX_L1N/ADC1IN1: C53.1, R86.1; also elsewhere on the board
DIFFIO_RX_L1P/ADC1IN2: C54.1, R87.1; also elsewhere on the board
DIFFIO_RX_L3N/ADC1IN3: C55.1, R88.1; also elsewhere on the board
DIFFIO_RX_L3P/ADC1IN4: C56.1, R89.1; also elsewhere on the board
DIFFIO_RX_L5N/ADC1IN5: C57.1, R90.1; also elsewhere on the board
DIFFIO_RX_L5P/ADC1IN6: C58.1, R91.1; also elsewhere on the board
DIFFIO_RX_L7N/ADC1IN7: C59.1, R92.1; also elsewhere on the board
DIFFIO_RX_L7P/ADC1IN8: C60.1, R93.1; also elsewhere on the board
Earth: C17.2, C18.2, C19.1, C20.1, C21.1, C22.1, C23.1, C24.1, C25.1, C26.1, C51.2, C52.2, C53.2, C54.2, C55.2, C56.2, C57.2, C58.2, C59.2, C60.2, J2.6, J2.7, J3.2, J6.3, R16.3, R78.1, R79.1, R80.1, R81.1, R82.1, R83.1, R84.1, R85.1, R94.3, U3.11 (V-), U4.11 (V-); also elsewhere on the board
unnamed: J6.2, R17.1
unnamed: J7.2, R19.1
unnamed: J7.3, R16.2, R94.2
unnamed: R15.2, R16.1, R94.1
unnamed: C22.2, R10.2, R78.2, U3.3 (+)
unnamed: C19.2, R8.2, R79.2, U3.5 (+)
unnamed: C21.2, R7.2, R80.2, U3.10 (+)
unnamed: C20.2, R9.2, R81.2, U3.12 (+)
unnamed: C25.2, R20.2, R82.2, U4.3 (+)
unnamed: C23.2, R18.2, R83.2, U4.5 (+)
unnamed: C26.2, R19.2, R84.2, U4.10 (+)
unnamed: C24.2, R17.2, R85.2, U4.12 (+)
RESET_N: J2.3; also elsewhere on the board
VBUS_5V: J2.5; also elsewhere on the board
VCCA_3.3V: C51.1, C52.1, R6.2, R15.1, U3.4 (V+), U4.4 (V+); also elsewhere on the board
VCCIO1A: C17.1, C18.1, R6.1; also elsewhere on the board
VCC_IO: J2.2; also elsewhere on the board

Notes on the sheet:
ARDUINO_IO13
ARDUINO_IO4
ANALOG_IN2
ARDUINO_IO12
ARDUINO_RESET_N
ANALOG SECTION
GND
ARDUINO_IO2
ARDUINO_IO10
ANALOG_IN0
IOREF
VCCI2
ARDUINO_IO9
ANALOG_IN1
ARDUINO_IO0
ANALOG_IN5
ARDUINO_IO8
ARDUINO_IO7
ANALOG_IN6
GND1
ANALOG_IN7
ARDUINO_IO1
ANALOG_IN4
ANALOG_IN3
Arduino Shield
ANALOG_VREF
VCC3P3
ARDUINO_IO11
VCC5
ARDUINO_IO6
ARDUINO_IO5
GND2
ARDUINO_IO3

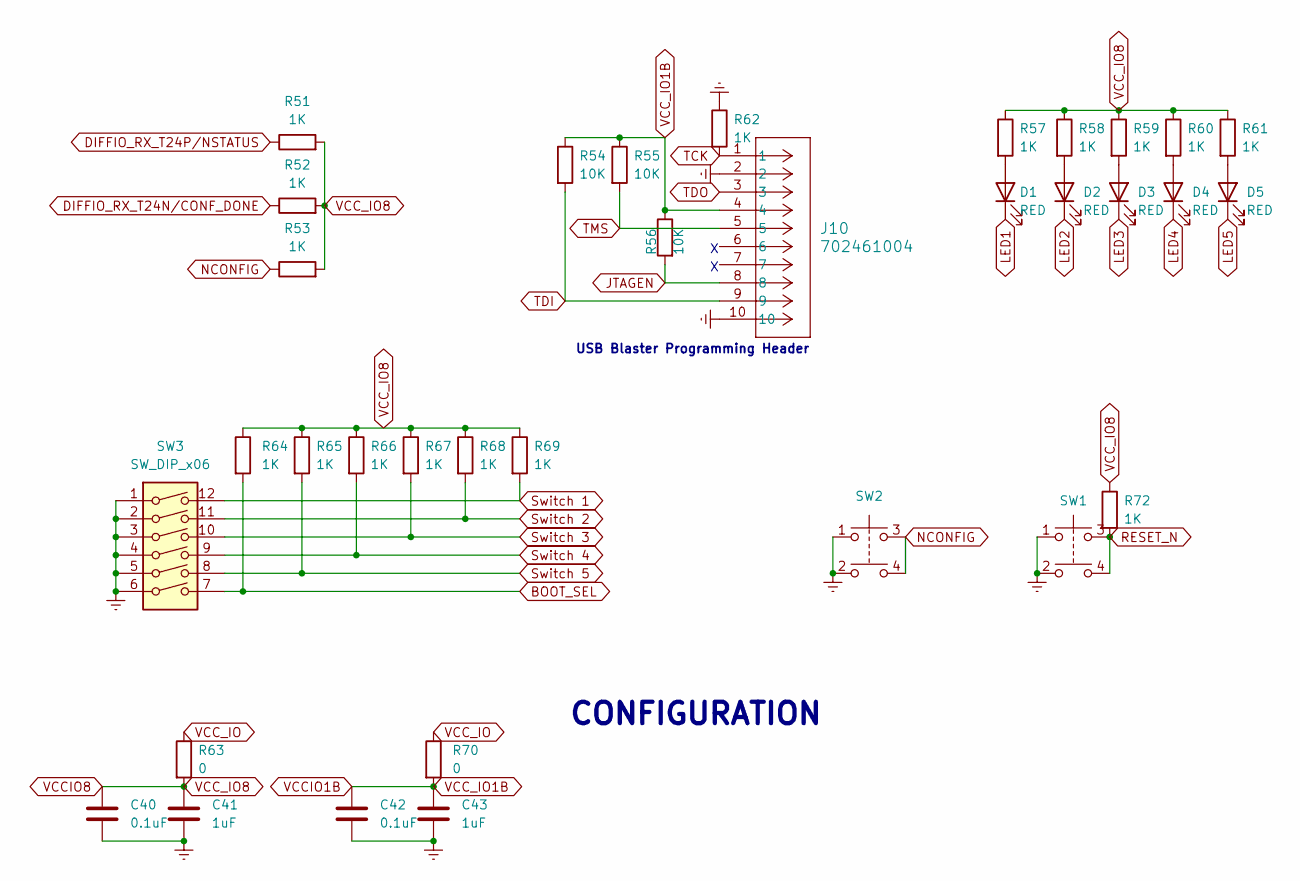
[picture p19: schematic config.kicad_sch]

Parts:
C40, C42: 0.1uF; C_0201_0603Metric
C41, C43: 1uF; C_0201_0603Metric
D1, D2, D3, D4, D5: RED; LED_0201_0603Metric
J10: 702461004; CON_702461004_MOL
R51, R52, R53, R57, R58, R59, R60, R61, R62, R64, R65, R66, R67, R68, R69, R72: 1K; R_0201_0603Metric
R54, R55, R56: 10K; R_0201_0603Metric
R63, R70: 0; R_0201_0603Metric
SW1, SW2: SWITCH_43SMTR92LFS
SW3: SW_DIP_x06; SW_DIP_SPSTx06_Slide_6.7x16.8mm_W6.73mm_P2.54mm_LowProfile_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

Connections:
BOOT_SEL: R64.2, SW3.7; also elsewhere on the board
DIFFIO_RX_T24N/CONF_DONE: R52.1; also elsewhere on the board
DIFFIO_RX_T24P/NSTATUS: R51.1; also elsewhere on the board
Earth: C40.2, C41.2, C42.2, C43.2, J10.2, J10.10, R62.1, SW1.1, SW1.2, SW2.1, SW2.2, SW3.1, SW3.2, SW3.3, SW3.4, SW3.5, SW3.6; also elsewhere on the board
JTAGEN: J10.8, R56.2; also elsewhere on the board
LED1: D1.1 (K); also elsewhere on the board
LED2: D2.1 (K); also elsewhere on the board
LED3: D3.1 (K); also elsewhere on the board
LED4: D4.1 (K); also elsewhere on the board
LED5: D5.1 (K); also elsewhere on the board
NCONFIG: R53.1, SW2.3, SW2.4; also elsewhere on the board
unnamed: D1.2 (A), R57.2
unnamed: D2.2 (A), R58.2
unnamed: D3.2 (A), R59.2
unnamed: D4.2 (A), R60.2
unnamed: D5.2 (A), R61.2
RESET_N: R72.2, SW1.3, SW1.4; also elsewhere on the board
Switch 1: R69.2, SW3.12; also elsewhere on the board
Switch 2: R68.2, SW3.11; also elsewhere on the board
Switch 3: R67.2, SW3.10; also elsewhere on the board
Switch 4: R66.2, SW3.9; also elsewhere on the board
Switch 5: R65.2, SW3.8; also elsewhere on the board
TCK: J10.1, R62.2; also elsewhere on the board
TDI: J10.9, R54.2; also elsewhere on the board
TDO: J10.3; also elsewhere on the board
TMS: J10.5, R55.2; also elsewhere on the board
VCCIO1B: C42.1, C43.1, J10.4, R54.1, R55.1, R56.1, R70.2; also elsewhere on the board
VCCIO8: C40.1, C41.1, R51.2, R52.2, R53.2, R57.1, R58.1, R59.1, R60.1, R61.1, R63.2, R64.1, R65.1, R66.1, R67.1, R68.1, R69.1, R72.1; also elsewhere on the board
VCC_IO: R63.1, R70.1; also elsewhere on the board

Notes on the sheet:
USB Blaster Programming Header
CONFIGURATION
