snevindsouza/MAX10_Eval_Board_Design/MAX10eval.kicad_pcb

## KiCad design MAX10eval.kicad_pcb (continued)

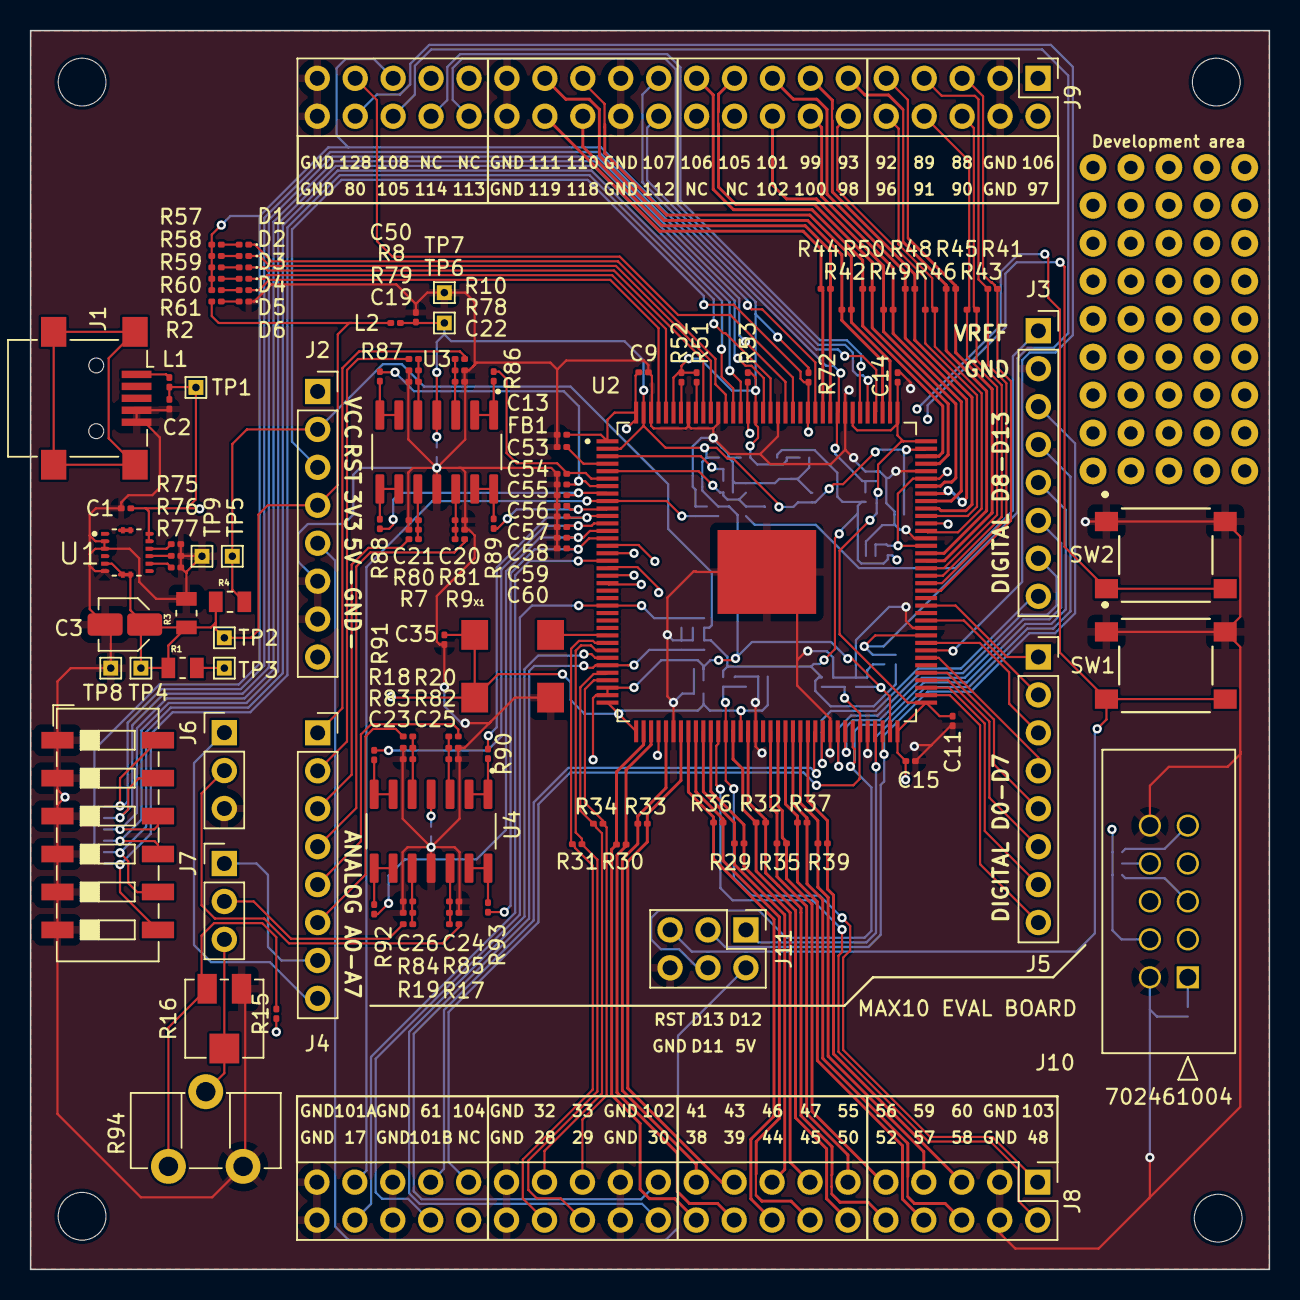
[picture p20: board MAX10eval.kicad_pcb from above]

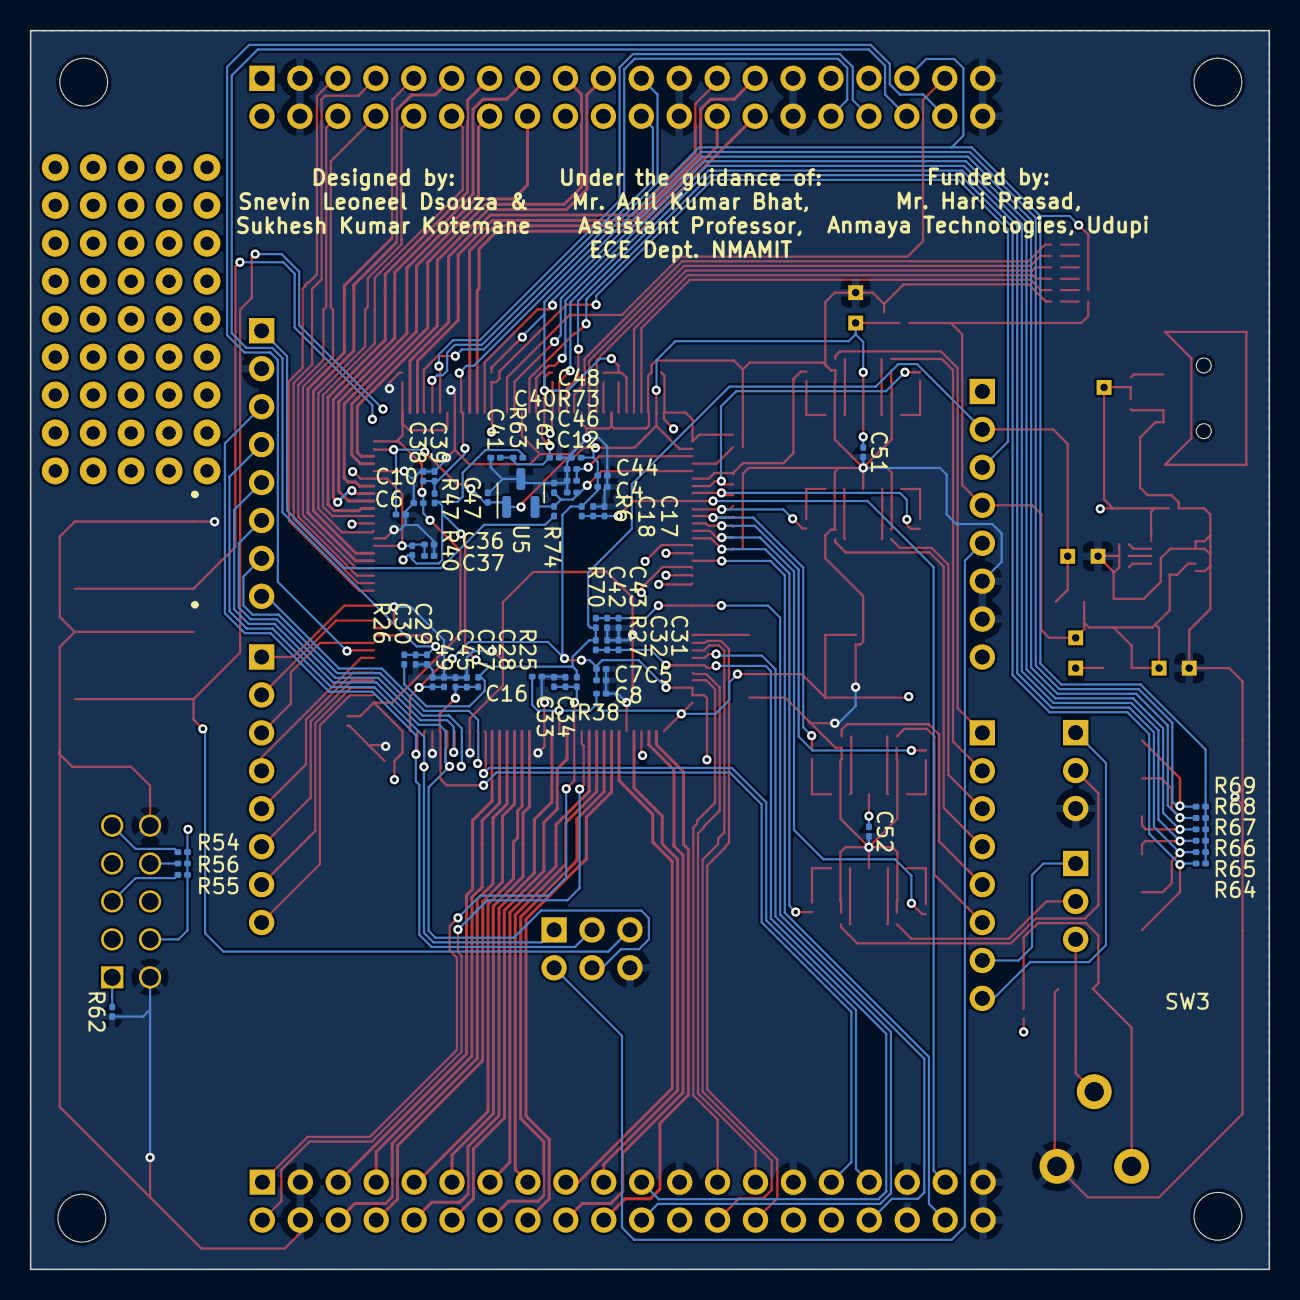
[picture p21: board MAX10eval.kicad_pcb from below]

Board: 4 copper layers, 82.9 x 82.9 mm, 186 parts (57 on the bottom side), 148 nets.
